Normansrule/arc22-scanner/docs/img/arc22_section_display.png

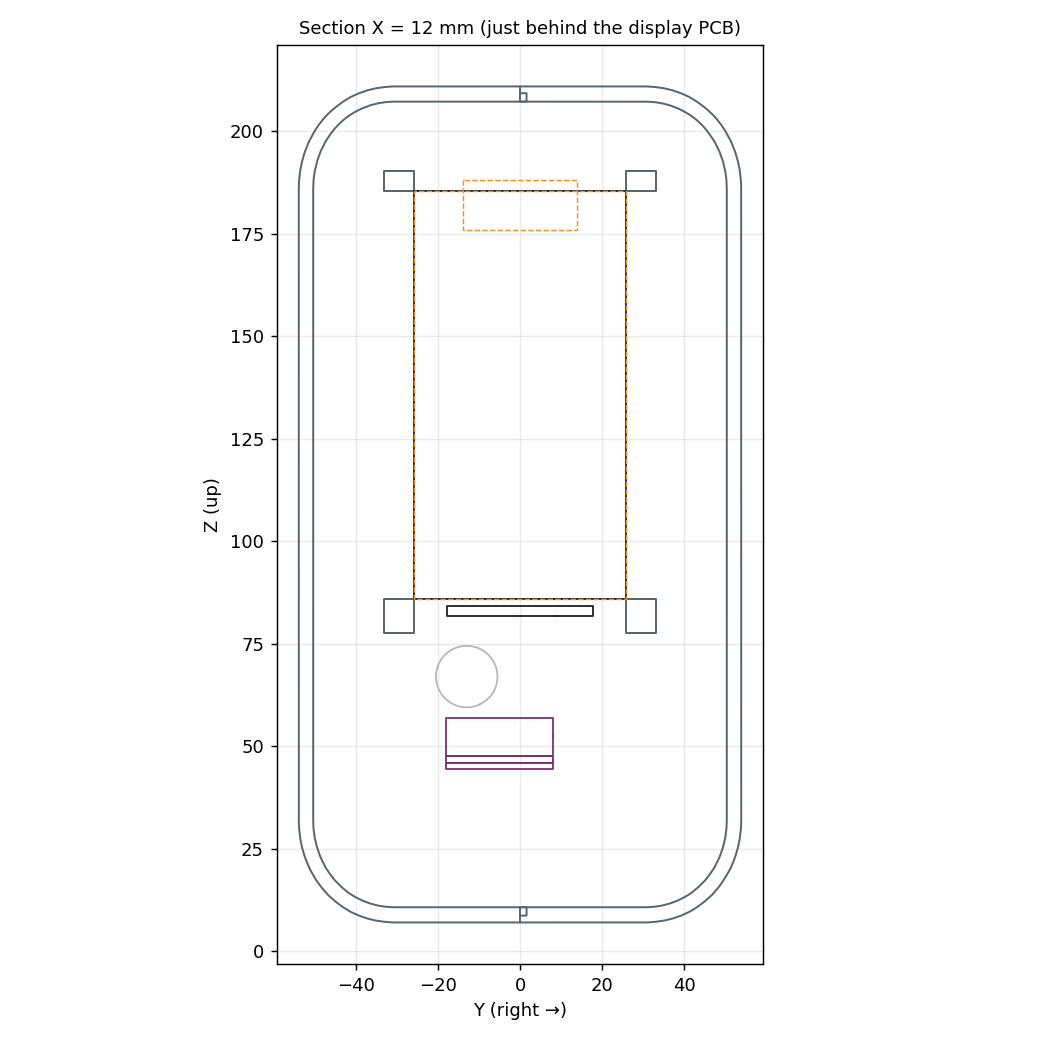
docs/img/arc22_section_display.png
