Normansrule/arc22-scanner/docs/img/arc22_section_esp32.png

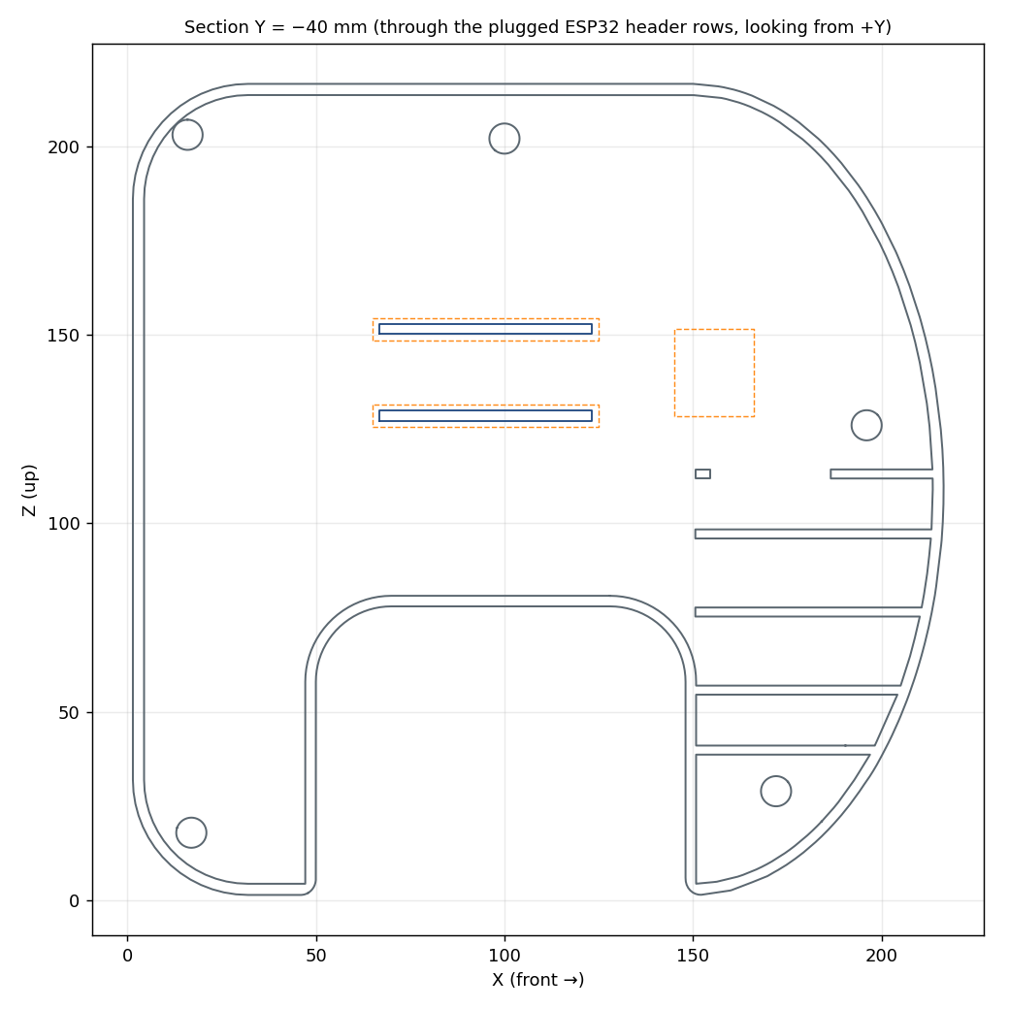
docs/img/arc22_section_esp32.png
