Normansrule/arc22-scanner/docs/img/arc22_section_seam.png

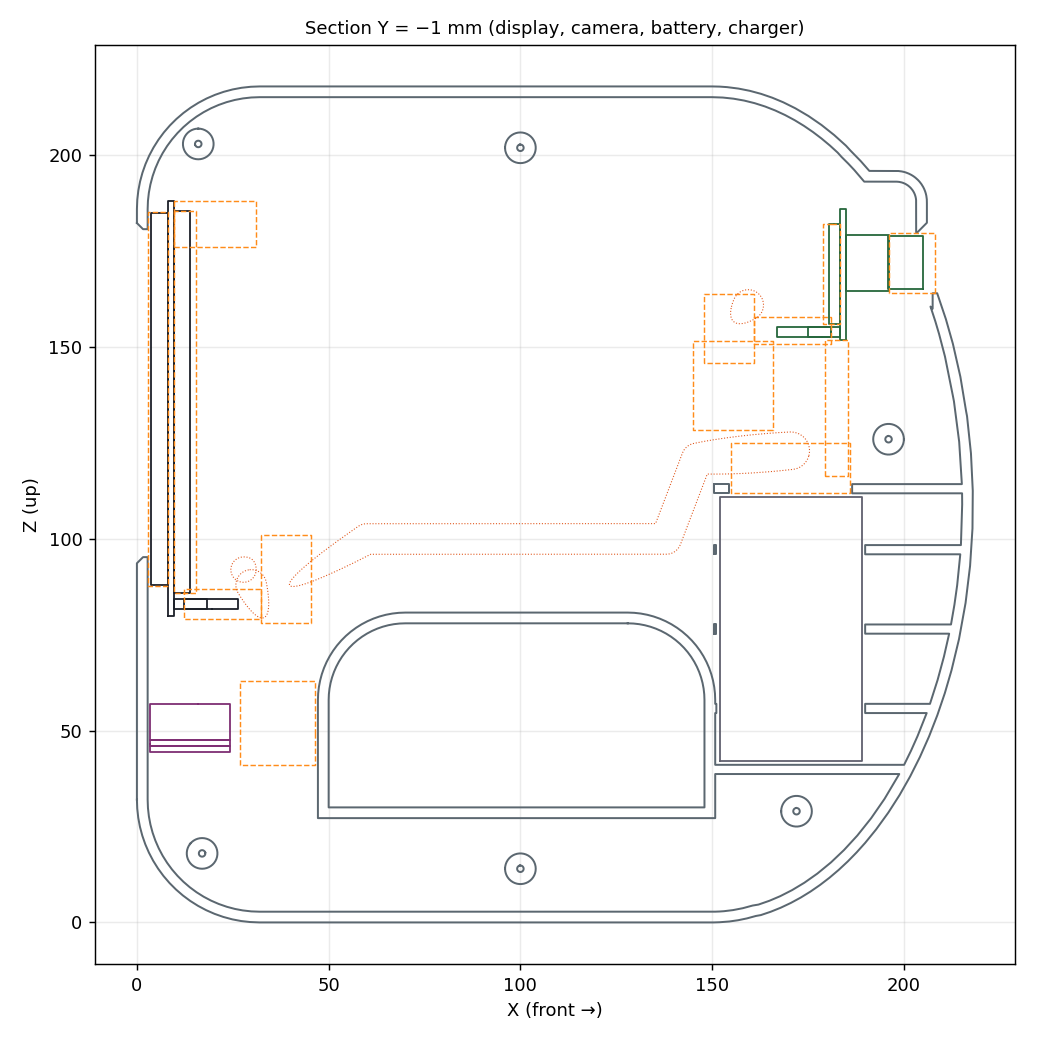
docs/img/arc22_section_seam.png
