Normansrule/arc22-scanner/docs/img/harness.png

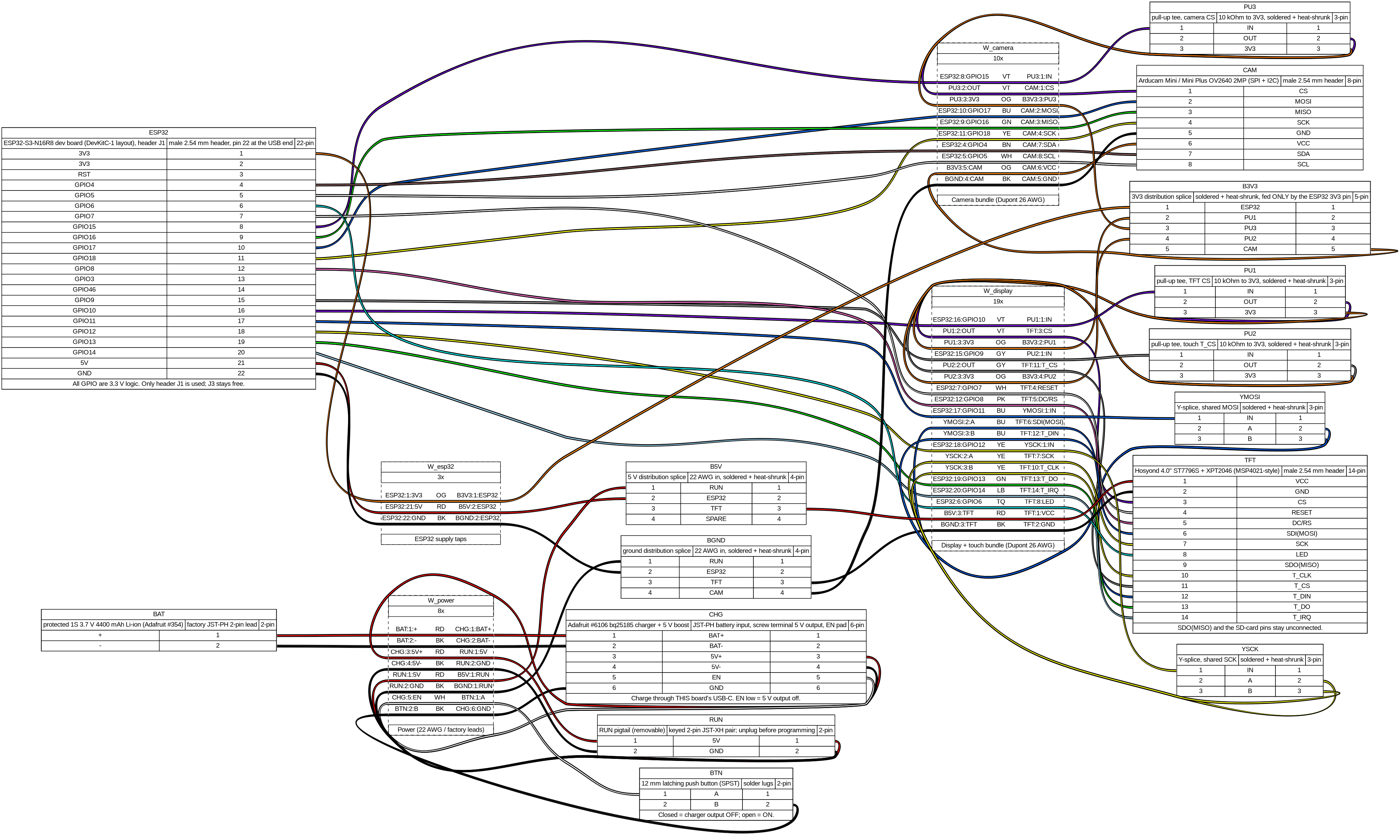
docs/img/harness.png
