Normansrule/arc22-scanner/cad/out/step/ARC22_ASSEMBLY.step

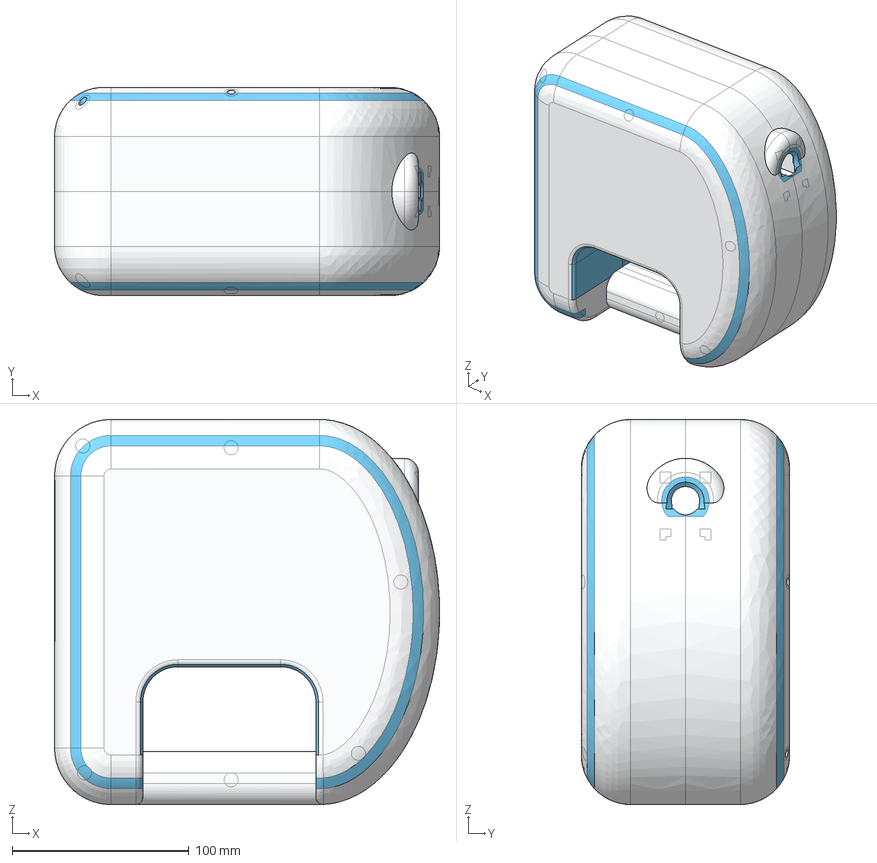
[picture p13: CAD file, 2026-10-02]
cad/out/step/ARC22_ASSEMBLY.step
217.9 x 118.0 x 218.0 mm
LEFT_WHITE
LEFT_BLUE
RIGHT_WHITE
RIGHT_BLUE
