Normansrule/arc22-scanner/cad/out/fit_samples/03_ESP32_WIRED_100x66x44_GAUGE.step

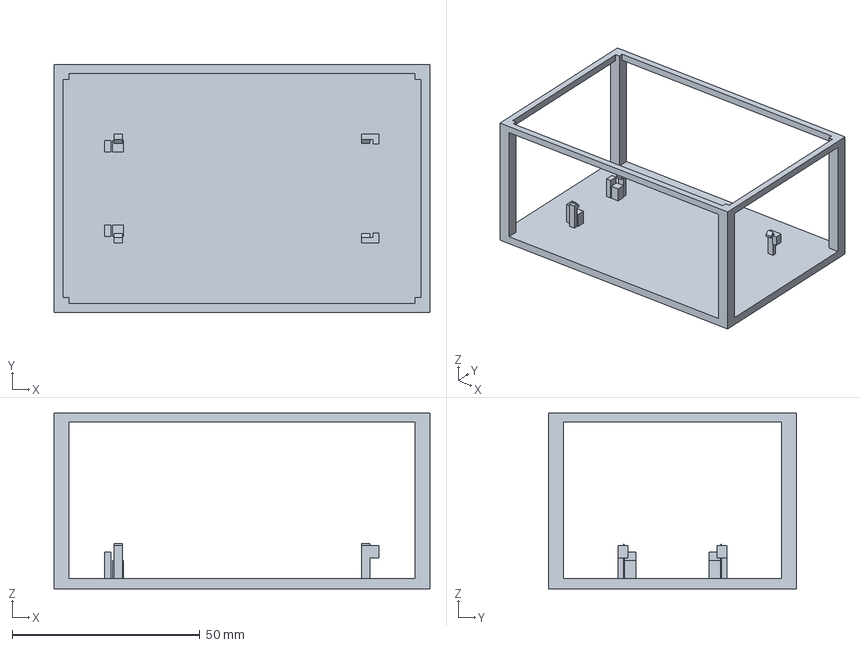
[picture p14: CAD file, 2026-10-02]
cad/out/fit_samples/03_ESP32_WIRED_100x66x44_GAUGE.step
100.0 x 66.0 x 46.8 mm
