Normansrule/arc22-scanner/cad/out/step/ARC22_RIGHT.step

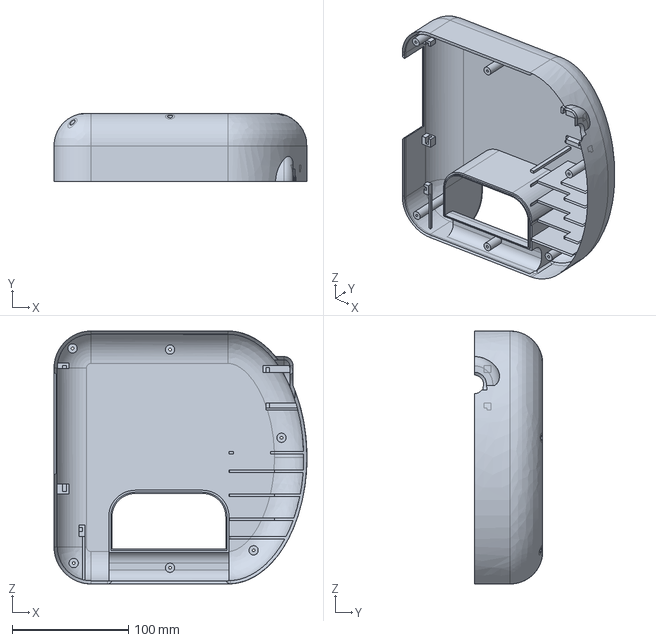
[picture p16: CAD file, 2026-10-02]
cad/out/step/ARC22_RIGHT.step
218.0 x 59.0 x 218.0 mm
