Normansrule/arc22-scanner/cad/reference_cad/ARC22_CLEARANCE_FIELDS.step

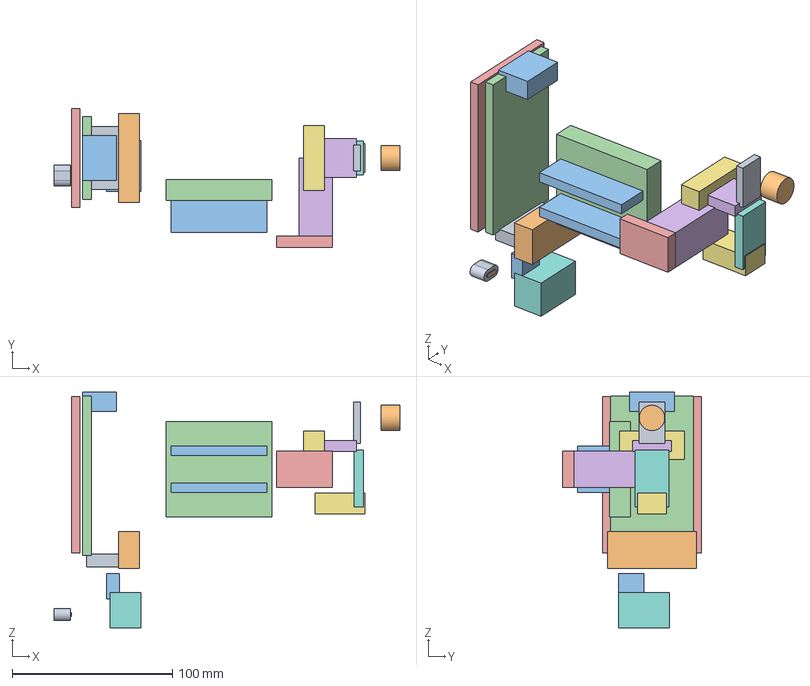
[picture p17: CAD file, 2026-10-02]
cad/reference_cad/ARC22_CLEARANCE_FIELDS.step
216.0 x 86.5 x 147.0 mm
display__hdr_wires_near
display__hdr_wires_bend
display__far_pins
display__open_back
display__glass_air
camera__wires_back_near
camera__wires_back_bend
camera__wires_down
camera__open_back
camera__lens_air
esp32__wires_near_lo
esp32__wires_near_hi
esp32__wires_bend
esp32__prog_usb
esp32__prog_exit
battery__leads
charger__wires
charger__plug_overmold_air
charger__plug_metal_air
button__leads
