Normansrule/arc22-scanner/docs/app/models/mod_display.stl

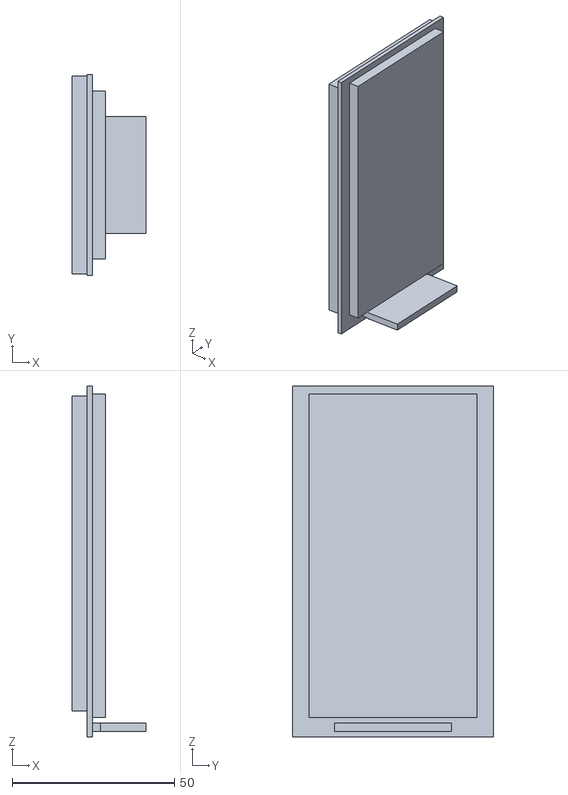
[picture p18: CAD file, 2026-10-02]
docs/app/models/mod_display.stl
22.7 x 61.7 x 108.0
