Normansrule/arc22-scanner/cad/out/fit_samples/01_SCREEN_76x124_BEZEL_AND_PADS.step

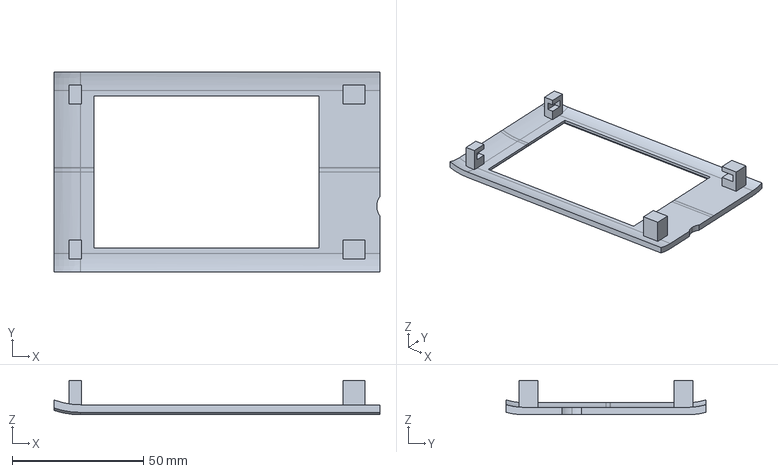
[picture p19: CAD file, 2026-10-02]
cad/out/fit_samples/01_SCREEN_76x124_BEZEL_AND_PADS.step
124.0 x 76.0 x 13.1 mm
