Normansrule/arc22-scanner/cad/out/print/stl/ARC22_LEFT_WHITE.stl

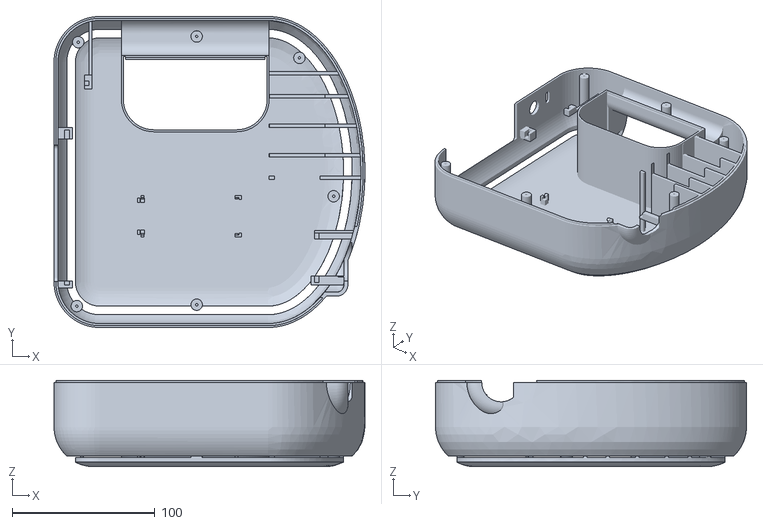
[picture p20: CAD file, 2026-10-02]
cad/out/print/stl/ARC22_LEFT_WHITE.stl
218.0 x 218.0 x 60.6
