Normansrule/arc22-scanner/cad/reference_cad/ARC22_TOPOLOGY.step

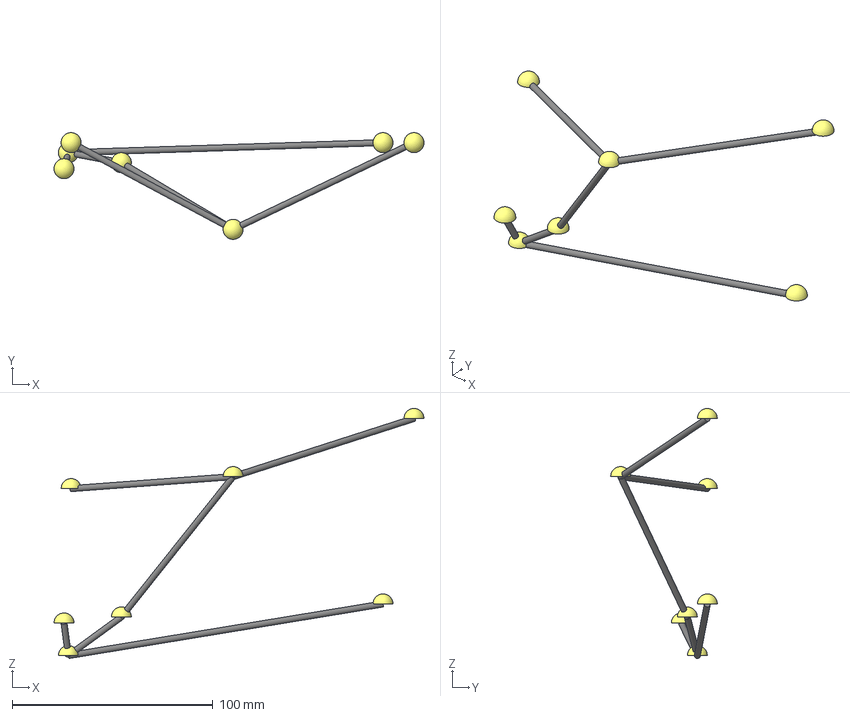
[picture p21: CAD file, 2026-10-02]
cad/reference_cad/ARC22_TOPOLOGY.step
184.5 x 53.2 x 124.7 mm
node_display
node_camera
node_esp32
node_battery
node_charger
node_button
node_run_pigtail
link_camera_esp32
link_esp32_display
link_battery_charger
link_charger_run_pigtail
link_run_pigtail_esp32
link_button_charger
