Normansrule/arc22-scanner/docs/app/models/field_display.stl

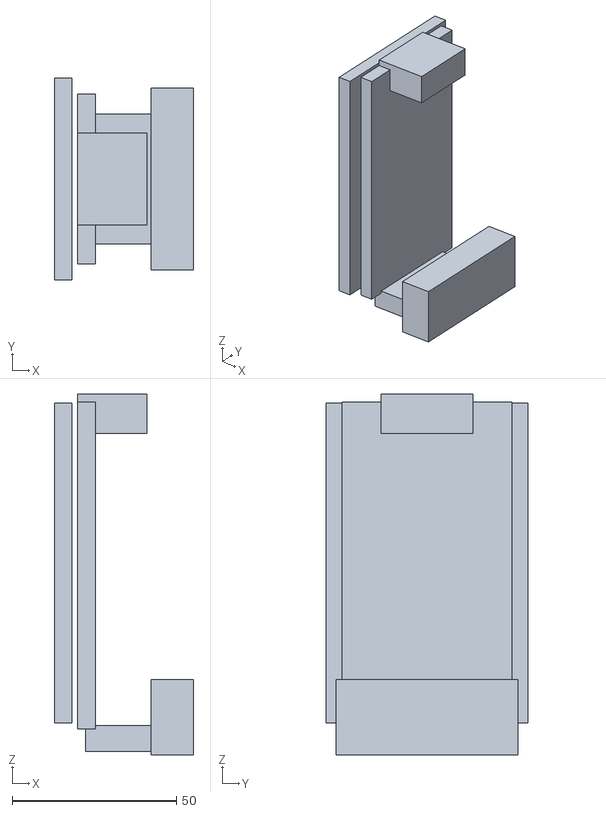
[picture p22: CAD file, 2026-10-02]
docs/app/models/field_display.stl
42.5 x 61.6 x 110.0
