Normansrule/arc22-scanner/cad/out/fit_samples/02_CAMERA_46x50_LENS_AND_PADS.step

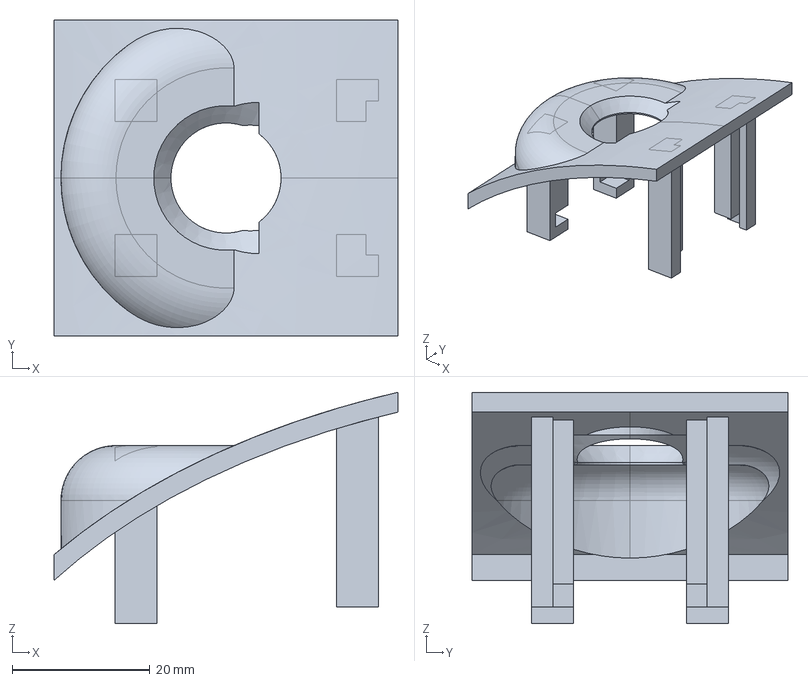
[picture p23: CAD file, 2026-10-02]
cad/out/fit_samples/02_CAMERA_46x50_LENS_AND_PADS.step
50.0 x 46.0 x 33.6 mm
