Normansrule/arc22-scanner/cad/out/print/stl/ARC22_RIGHT_WHITE.stl

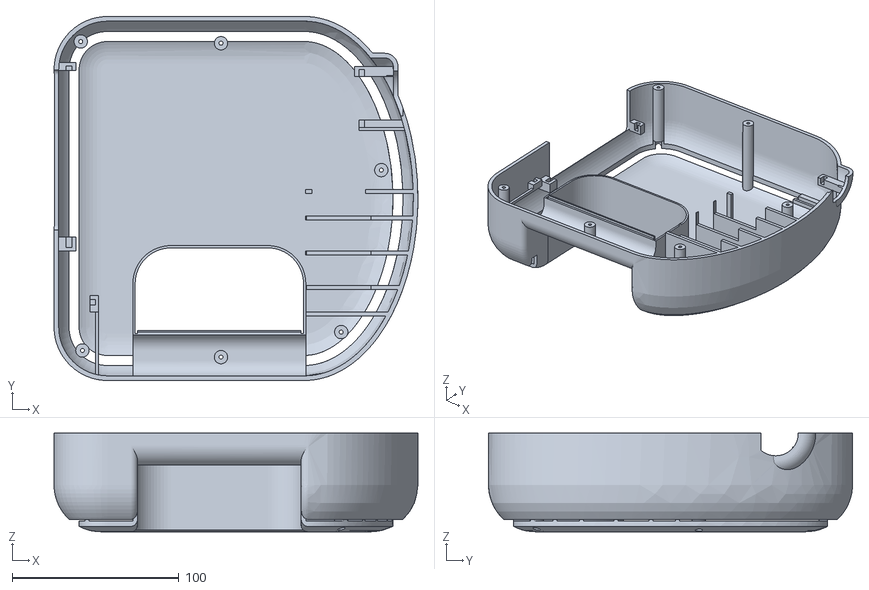
[picture p24: CAD file, 2026-10-02]
cad/out/print/stl/ARC22_RIGHT_WHITE.stl
218.0 x 218.0 x 59.0
