Normansrule/arc22-scanner/cad/out/step/ARC22_RIGHT_2COLOR.step

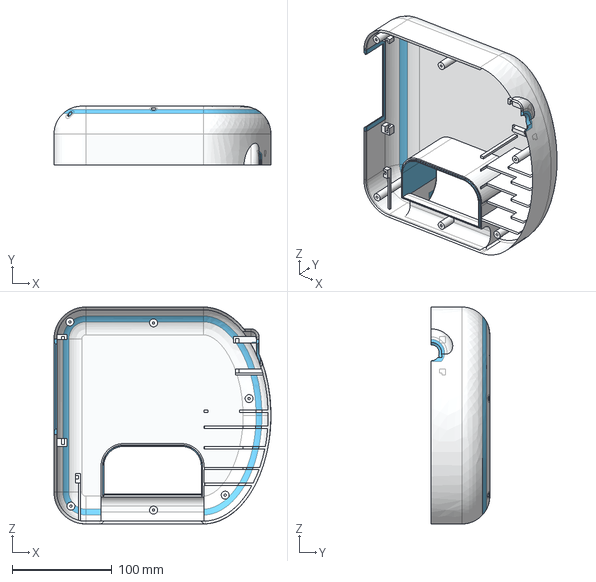
[picture p25: CAD file, 2026-10-02]
cad/out/step/ARC22_RIGHT_2COLOR.step
218.0 x 59.0 x 218.0 mm
RIGHT_WHITE
RIGHT_BLUE
