Normansrule/arc22-scanner/cad/reference_cad/ARC22_REFERENCE_MODULES.step

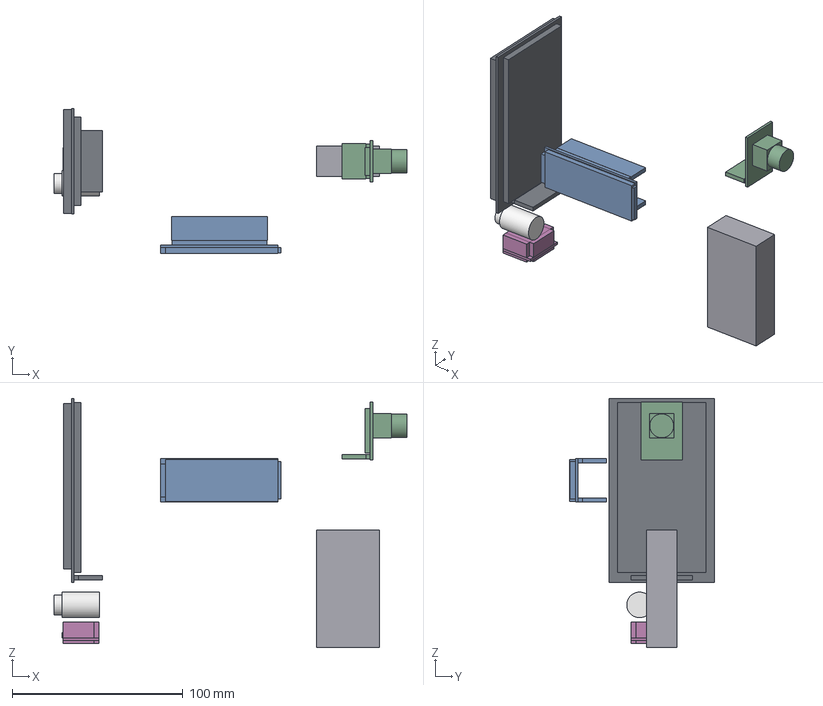
[picture p26: CAD file, 2026-10-02]
cad/reference_cad/ARC22_REFERENCE_MODULES.step
207.0 x 84.9 x 146.0 mm
display__pcb
display__glass
display__back_parts
display__header
display__plugs
camera__pcb
camera__holder
camera__lens
camera__back_parts
camera__header
camera__plugs
esp32__pcb
esp32__top_parts
esp32__top_parts_mid
esp32__usb
esp32__header_lo
esp32__plugs_lo
esp32__header_hi
esp32__plugs_hi
battery__pack
charger__pcb
charger__parts_top
charger__parts_bottom
charger__usb_c
button__body
button__cap
