Normansrule/arc22-scanner/docs/app/models/mod_battery.stl

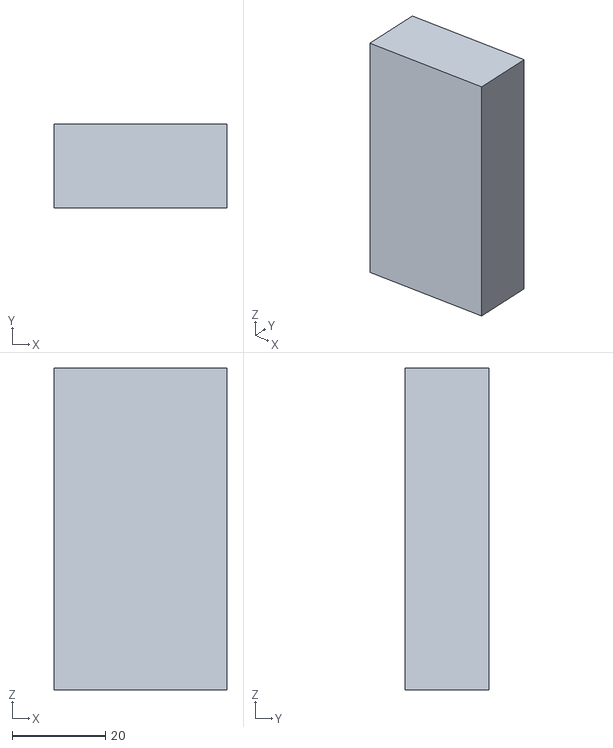
[picture p27: CAD file, 2026-10-02]
docs/app/models/mod_battery.stl
37.0 x 18.0 x 69.0
