Normansrule/arc22-scanner/cad/out/print/stl/ARC22_LEFT_BLUE.stl

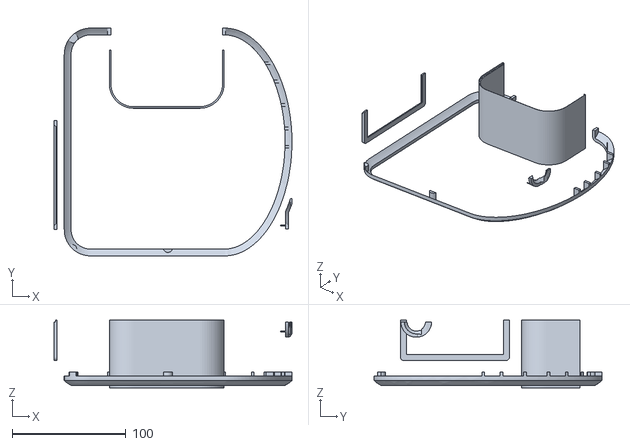
[picture p28: CAD file, 2026-10-02]
cad/out/print/stl/ARC22_LEFT_BLUE.stl
209.0 x 200.0 x 59.6
