Normansrule/arc22-scanner/cad/out/step/ARC22_LEFT.step

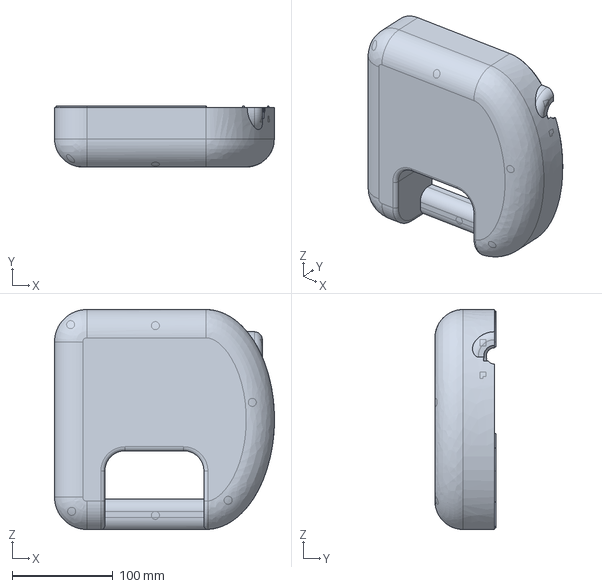
[picture p29: CAD file, 2026-10-02]
cad/out/step/ARC22_LEFT.step
218.0 x 60.6 x 218.0 mm
