Normansrule/arc22-scanner/cad/reference_cad/ARC22_WIRE_ROUTES.step

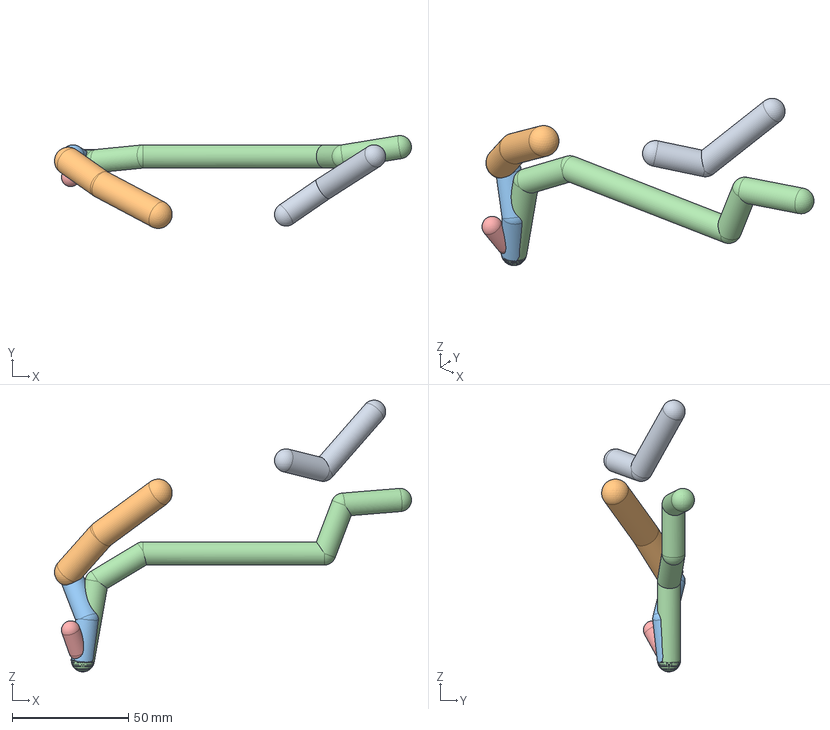
[picture p30: CAD file, 2026-10-02]
cad/reference_cad/ARC22_WIRE_ROUTES.step
153.7 x 40.0 x 117.0 mm
camera_to_esp32
esp32_to_display
power_trunk_to_charger
battery_to_charger
button_to_charger
