Normansrule/arc22-scanner/docs/app/models/mod_button.stl

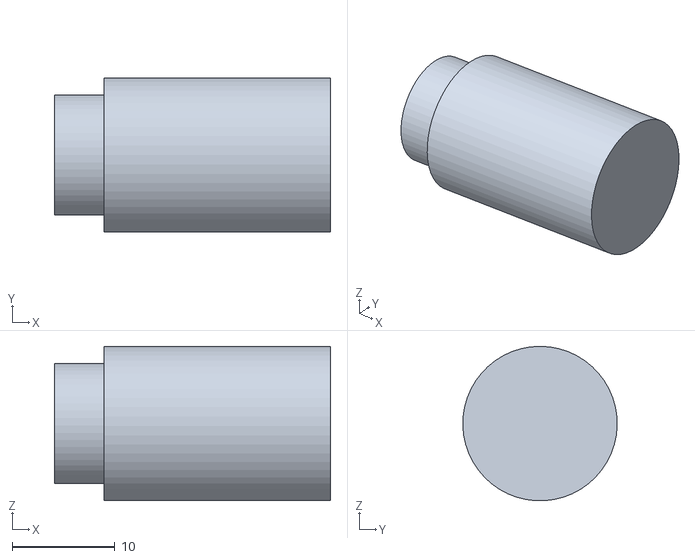
[picture p31: CAD file, 2026-10-02]
docs/app/models/mod_button.stl
26.8 x 15.0 x 15.0
