Normansrule/arc22-scanner/cad/out/step/ARC22_LEFT_2COLOR.step

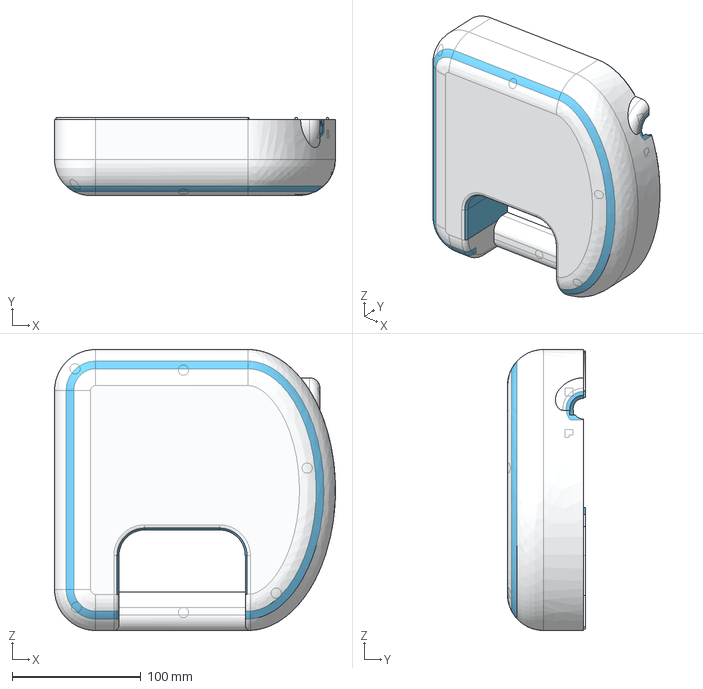
[picture p32: CAD file, 2026-10-02]
cad/out/step/ARC22_LEFT_2COLOR.step
218.0 x 60.6 x 218.0 mm
LEFT_WHITE
LEFT_BLUE
