Normansrule/arc22-scanner/docs/app/models/mod_esp32.stl

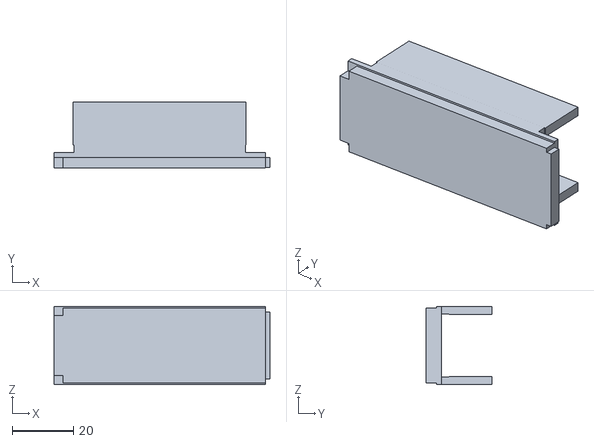
[picture p33: CAD file, 2026-10-02]
docs/app/models/mod_esp32.stl
70.5 x 21.5 x 25.6
