Normansrule/arc22-scanner/docs/app/models/field_button.stl

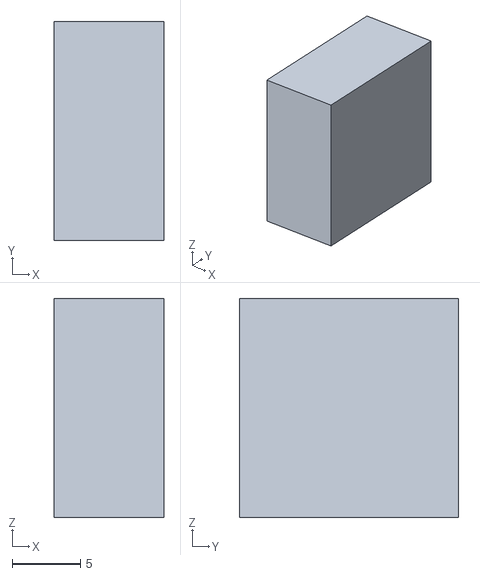
[picture p34: CAD file, 2026-10-02]
docs/app/models/field_button.stl
8.00 x 16.0 x 16.0
