Normansrule/arc22-scanner/docs/app/models/routes.stl

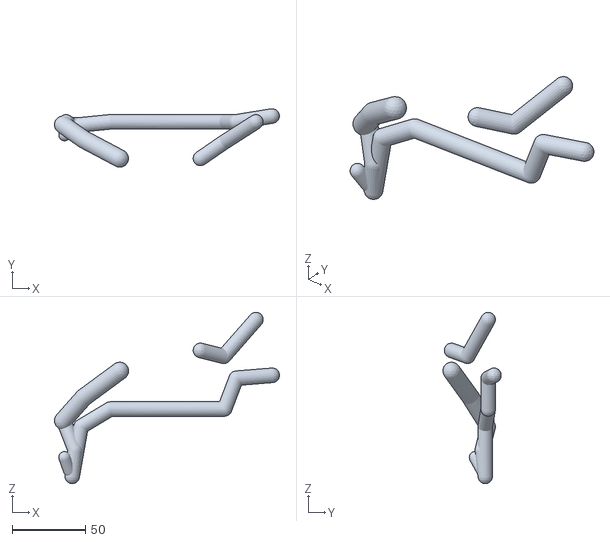
[picture p35: CAD file, 2026-10-02]
docs/app/models/routes.stl
153.6 x 39.9 x 117.0
