Normansrule/arc22-scanner/docs/app/models/mod_charger.stl

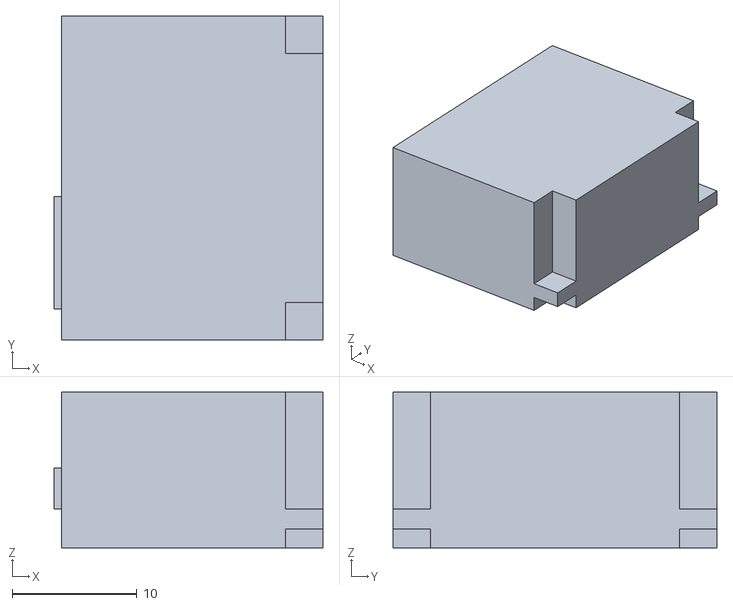
[picture p36: CAD file, 2026-10-02]
docs/app/models/mod_charger.stl
21.6 x 26.0 x 12.5
