Normansrule/arc22-scanner/docs/app/models/field_charger.stl

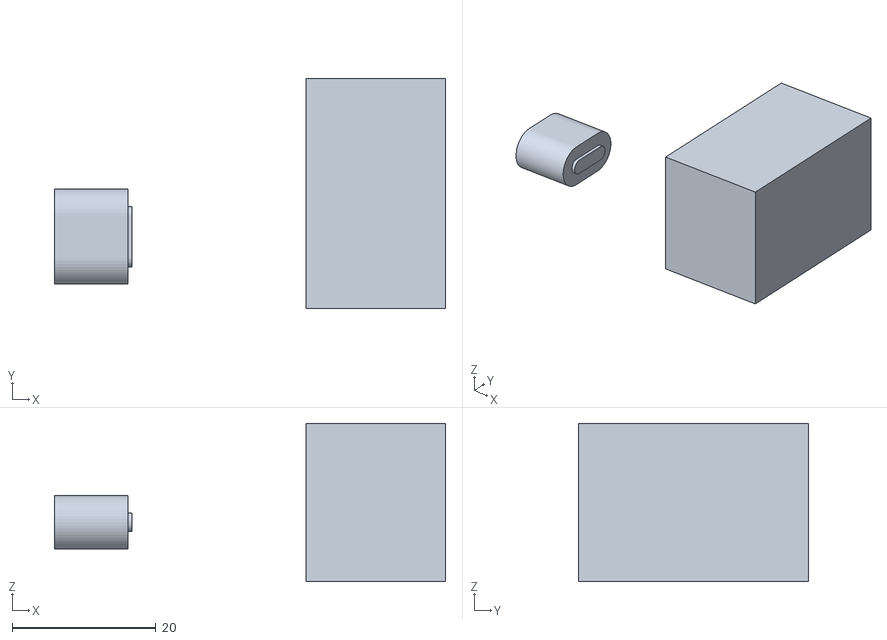
[picture p37: CAD file, 2026-10-02]
docs/app/models/field_charger.stl
54.4 x 32.0 x 22.0
