Normansrule/arc22-scanner/docs/app/models/field_battery.stl

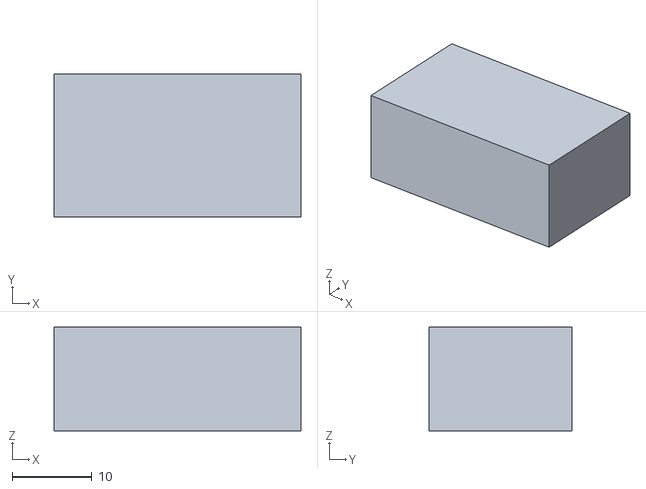
[picture p38: CAD file, 2026-10-02]
docs/app/models/field_battery.stl
31.0 x 18.0 x 13.0
