Normansrule/arc22-scanner/docs/app/models/mod_camera.stl

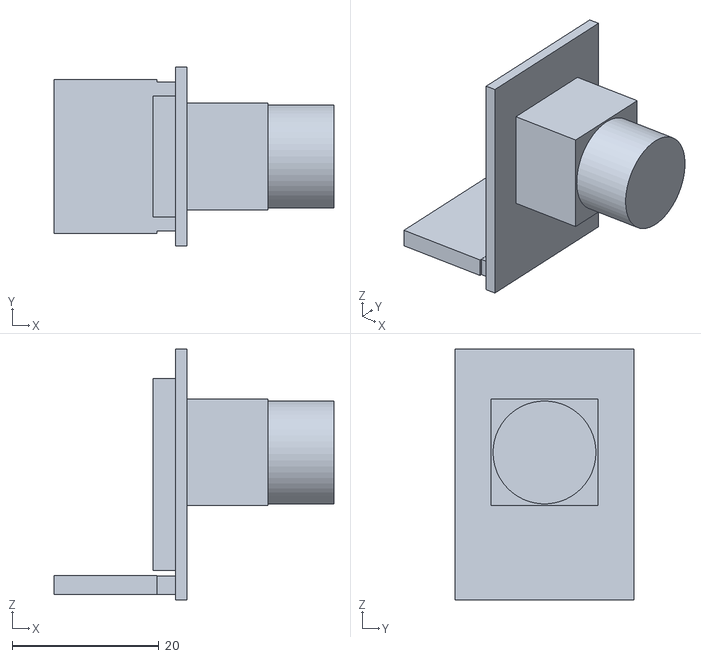
[picture p39: CAD file, 2026-10-02]
docs/app/models/mod_camera.stl
38.1 x 24.4 x 34.1
