Normansrule/arc22-scanner/docs/app/models/field_camera.stl

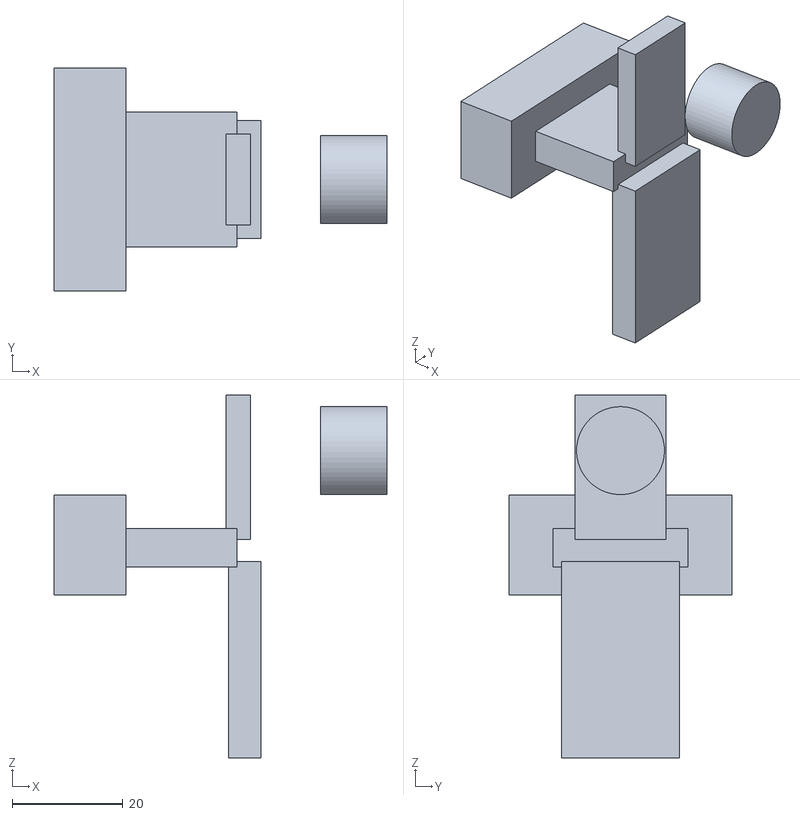
[picture p40: CAD file, 2026-10-02]
docs/app/models/field_camera.stl
60.1 x 40.3 x 65.6
