Normansrule/arc22-scanner/docs/app/models/field_esp32.stl

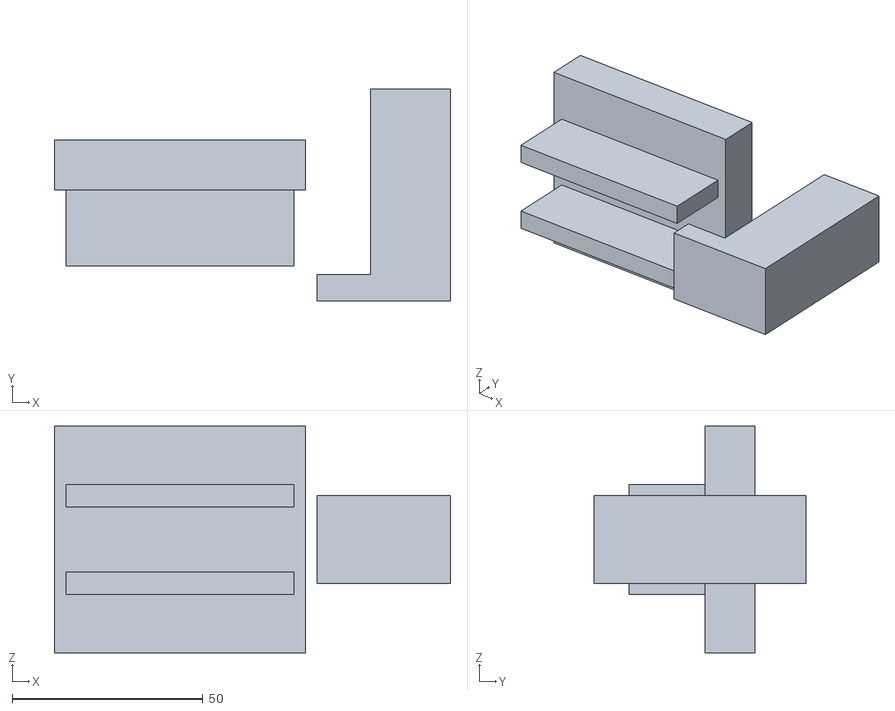
[picture p41: CAD file, 2026-10-02]
docs/app/models/field_esp32.stl
103.9 x 55.8 x 59.5
