Normansrule/arc22-scanner/(list of files, cad)

Other CAD files:
docs/app/models/RIGHT_BLUE.stl
docs/app/models/LEFT_WHITE.stl
docs/app/models/RIGHT_WHITE.stl
docs/app/models/LEFT_BLUE.stl
cad/out/fit_samples/01_SCREEN_76x124_BEZEL_AND_PADS.stl
cad/out/fit_samples/02_CAMERA_46x50_LENS_AND_PADS.stl
cad/out/fit_samples/03_ESP32_WIRED_100x66x44_GAUGE.stl
cad/out/print/3mf/ARC22_LEFT_2COLOR.3mf
cad/out/print/3mf/ARC22_RIGHT_2COLOR.3mf
cad/out/print/ARC22_LEFT.obj
cad/out/print/ARC22_RIGHT.obj
