Normansrule/arc22-scanner/docs/validation/cad_checks.md

# Recorded CAD checks (auto-generated by `cad/validate_arc22.py`)

These are **RECORDED CAD/mesh checks**, not physical tests. 57 measurements are still marked VERIFY, so a PASS means the model is self-consistent with nominal numbers — nothing more.

**99 / 99 passed, 0 failed.**

| Group | Item | Result | Value | Note |
|---|---|---|---|---|
| envelope | bounds X×Y×Z (front-back × width × height) | PASS | 218.0 × 118.0 × 218.0 mm | ARC22 target ~218 × 118 × 218 |
| envelope | LEFT one solid, valid | PASS | 1 solid(s) |  |
| printer | LEFT on P1S bed (exterior down) | PASS | footprint 218.0 × 218.0, height 60.6 mm | bed 256³ minus 10 mm margin for brim/purge/exclusions |
| envelope | RIGHT one solid, valid | PASS | 1 solid(s) |  |
| printer | RIGHT on P1S bed (exterior down) | PASS | footprint 218.0 × 218.0, height 59.0 mm | bed 256³ minus 10 mm margin for brim/purge/exclusions |
| hard parts vs shells | battery.pack | PASS | 0.00 mm³ |  |
| hard parts vs shells | button.body | PASS | 0.00 mm³ |  |
| hard parts vs shells | button.cap | PASS | 0.00 mm³ |  |
| hard parts vs shells | camera.back_parts | PASS | 0.00 mm³ |  |
| hard parts vs shells | camera.header | PASS | 0.00 mm³ |  |
| hard parts vs shells | camera.holder | PASS | 0.00 mm³ |  |
| hard parts vs shells | camera.lens | PASS | 0.00 mm³ |  |
| hard parts vs shells | camera.pcb | PASS | 0.00 mm³ |  |
| hard parts vs shells | camera.plugs | PASS | 0.00 mm³ |  |
| hard parts vs shells | charger.parts_bottom | PASS | 0.00 mm³ |  |
| hard parts vs shells | charger.parts_top | PASS | 0.00 mm³ |  |
| hard parts vs shells | charger.pcb | PASS | 0.00 mm³ |  |
| hard parts vs shells | charger.usb_c | PASS | 0.00 mm³ |  |
| hard parts vs shells | display.back_parts | PASS | 0.00 mm³ |  |
| hard parts vs shells | display.glass | PASS | 0.00 mm³ |  |
| hard parts vs shells | display.header | PASS | 0.00 mm³ |  |
| hard parts vs shells | display.pcb | PASS | 0.00 mm³ |  |
| hard parts vs shells | display.plugs | PASS | 0.00 mm³ |  |
| hard parts vs shells | esp32.header_hi | PASS | 0.00 mm³ |  |
| hard parts vs shells | esp32.header_lo | PASS | 0.00 mm³ |  |
| hard parts vs shells | esp32.pcb | PASS | 0.00 mm³ |  |
| hard parts vs shells | esp32.plugs_hi | PASS | 0.00 mm³ |  |
| hard parts vs shells | esp32.plugs_lo | PASS | 0.00 mm³ |  |
| hard parts vs shells | esp32.top_parts | PASS | 0.00 mm³ |  |
| hard parts vs shells | esp32.top_parts_mid | PASS | 0.00 mm³ |  |
| hard parts vs shells | esp32.usb | PASS | 0.00 mm³ |  |
| reserved fields vs shells | battery.leads | PASS | 0.00 mm³ | wire/air space stays free of plastic |
| reserved fields vs shells | button.leads | PASS | 0.00 mm³ | wire/air space stays free of plastic |
| reserved fields vs shells | camera.lens_air | PASS | 0.00 mm³ | wire/air space stays free of plastic |
| reserved fields vs shells | camera.open_back | PASS | 0.00 mm³ | wire/air space stays free of plastic |
| reserved fields vs shells | camera.wires_back_bend | PASS | 0.00 mm³ | wire/air space stays free of plastic |
| reserved fields vs shells | camera.wires_back_near | PASS | 0.00 mm³ | wire/air space stays free of plastic |
| reserved fields vs shells | camera.wires_down | PASS | 0.00 mm³ | wire/air space stays free of plastic |
| reserved fields vs shells | charger.plug_metal_air | PASS | 0.00 mm³ | wire/air space stays free of plastic |
| reserved fields vs shells | charger.plug_overmold_air | PASS | 0.00 mm³ | wire/air space stays free of plastic |
| reserved fields vs shells | charger.wires | PASS | 0.00 mm³ | wire/air space stays free of plastic |
| reserved fields vs shells | display.far_pins | PASS | 0.00 mm³ | wire/air space stays free of plastic |
| reserved fields vs shells | display.glass_air | PASS | 0.00 mm³ | wire/air space stays free of plastic |
| reserved fields vs shells | display.hdr_wires_bend | PASS | 0.00 mm³ | wire/air space stays free of plastic |
| reserved fields vs shells | display.hdr_wires_near | PASS | 0.00 mm³ | wire/air space stays free of plastic |
| reserved fields vs shells | display.open_back | PASS | 0.00 mm³ | wire/air space stays free of plastic |
| reserved fields vs shells | esp32.prog_exit | PASS | 0.00 mm³ | wire/air space stays free of plastic |
| reserved fields vs shells | esp32.prog_usb | PASS | 0.00 mm³ | wire/air space stays free of plastic |
| reserved fields vs shells | esp32.wires_bend | PASS | 0.00 mm³ | wire/air space stays free of plastic |
| reserved fields vs shells | esp32.wires_near_hi | PASS | 0.00 mm³ | wire/air space stays free of plastic |
| reserved fields vs shells | esp32.wires_near_lo | PASS | 0.00 mm³ | wire/air space stays free of plastic |
| module-to-module room | battery ↔ button | PASS | 0.00 mm³ | hard parts never sit in another module's wire field |
| module-to-module room | battery ↔ camera | PASS | 0.00 mm³ | hard parts never sit in another module's wire field |
| module-to-module room | battery ↔ charger | PASS | 0.00 mm³ | hard parts never sit in another module's wire field |
| module-to-module room | battery ↔ display | PASS | 0.00 mm³ | hard parts never sit in another module's wire field |
| module-to-module room | battery ↔ esp32 | PASS | 0.00 mm³ | hard parts never sit in another module's wire field |
| module-to-module room | button ↔ camera | PASS | 0.00 mm³ | hard parts never sit in another module's wire field |
| module-to-module room | button ↔ charger | PASS | 0.00 mm³ | hard parts never sit in another module's wire field |
| module-to-module room | button ↔ display | PASS | 0.00 mm³ | hard parts never sit in another module's wire field |
| module-to-module room | button ↔ esp32 | PASS | 0.00 mm³ | hard parts never sit in another module's wire field |
| module-to-module room | camera ↔ charger | PASS | 0.00 mm³ | hard parts never sit in another module's wire field |
| module-to-module room | camera ↔ display | PASS | 0.00 mm³ | hard parts never sit in another module's wire field |
| module-to-module room | camera ↔ esp32 | PASS | 0.00 mm³ | hard parts never sit in another module's wire field |
| module-to-module room | charger ↔ display | PASS | 0.00 mm³ | hard parts never sit in another module's wire field |
| module-to-module room | charger ↔ esp32 | PASS | 0.00 mm³ | hard parts never sit in another module's wire field |
| module-to-module room | display ↔ esp32 | PASS | 0.00 mm³ | hard parts never sit in another module's wire field |
| insertion path (swept) | battery | PASS | 0.00 mm³ | path (+0,+80,+0) → (+0,+0,+0) mm into the LEFT shell (plugs fitted), checked every 1 mm |
| insertion path (swept) | button | PASS | 0.00 mm³ | path (+6,+80,+0) → (+6,+0,+0) → (+0,+0,+0) mm into the LEFT shell (plugs fitted), checked every 1 mm |
| insertion path (swept) | camera | PASS | 0.00 mm³ | path (+0,+80,+0) → (+0,+0,+0) mm into the LEFT shell (plugs fitted), checked every 1 mm |
| insertion path (swept) | charger | PASS | 0.00 mm³ | path (+0,+80,+0) → (+0,+0,+0) mm into the LEFT shell (plugs fitted), checked every 1 mm |
| insertion path (swept) | display | PASS | 0.00 mm³ | path (+0,+80,+0) → (+0,+0,+0) mm into the LEFT shell (plugs fitted), checked every 1 mm |
| insertion path (swept) | esp32 | PASS | 0.00 mm³ | path (+0,+80,+0) → (+0,+0,+0) mm into the LEFT shell (plugs fitted), checked every 1 mm; snap clips engage up to 6.9 mm³ (intended, hook 0.8 mm) |
| closing swept volume | RIGHT shell descending onto fully wired LEFT half | PASS | 0.00 mm³ | includes plugged housings, wire fields and cable routes; checked every 1 mm |
| closing swept volume | RIGHT shell at final position vs installed stack | PASS | 0.00 mm³ | halves meet with no module pressure → close by hand before screws |
| cable routes | camera_to_esp32 inside cavity | PASS | 0.00 mm³ plastic |  |
| cable routes | camera_to_esp32 clear of hard parts | PASS | 0.0 mm³ | ends touch the header/plug zone by design (≤ 50 mm³ allowed) |
| cable routes | esp32_to_display inside cavity | PASS | 0.00 mm³ plastic |  |
| cable routes | esp32_to_display clear of hard parts | PASS | 12.9 mm³ | ends touch the header/plug zone by design (≤ 50 mm³ allowed) |
| cable routes | power_trunk_to_charger inside cavity | PASS | 0.00 mm³ plastic |  |
| cable routes | power_trunk_to_charger clear of hard parts | PASS | 0.5 mm³ | ends touch the header/plug zone by design (≤ 50 mm³ allowed) |
| cable routes | battery_to_charger inside cavity | PASS | 0.00 mm³ plastic |  |
| cable routes | battery_to_charger clear of hard parts | PASS | 0.0 mm³ | ends touch the header/plug zone by design (≤ 50 mm³ allowed) |
| cable routes | button_to_charger inside cavity | PASS | 0.00 mm³ plastic |  |
| cable routes | button_to_charger clear of hard parts | PASS | 0.0 mm³ | ends touch the header/plug zone by design (≤ 50 mm³ allowed) |
| hand loop | loop opening never reaches the electronics cavity | PASS | 0.00 mm³ | loop wall 2.8 mm all round |
| screws | S1_rear_top boss clear of every module | PASS | 12.2 mm gap | screws clamp shell to shell only — never a module |
| screws | S1_rear_top pilot stays blind (left skin ≥ 1.0 mm) | PASS | skin 45.42 mm, M2×12, engagement 7 mm, well 49.42 mm deep |  |
| screws | S2_top_mid boss clear of every module | PASS | 45.2 mm gap | screws clamp shell to shell only — never a module |
| screws | S2_top_mid pilot stays blind (left skin ≥ 1.0 mm) | PASS | skin 48.83 mm, M2×12, engagement 7 mm, well 52.83 mm deep |  |
| screws | S3_bow boss clear of every module | PASS | 12.6 mm gap | screws clamp shell to shell only — never a module |
| screws | S3_bow pilot stays blind (left skin ≥ 1.0 mm) | PASS | skin 49.84 mm, M2×12, engagement 7 mm, well 53.84 mm deep |  |
| screws | S4_front_low boss clear of every module | PASS | 9.0 mm gap | screws clamp shell to shell only — never a module |
| screws | S4_front_low pilot stays blind (left skin ≥ 1.0 mm) | PASS | skin 49.5 mm, M2×12, engagement 7 mm, well 53.5 mm deep |  |
| screws | S5_rear_low boss clear of every module | PASS | 22.5 mm gap | screws clamp shell to shell only — never a module |
| screws | S5_rear_low pilot stays blind (left skin ≥ 1.0 mm) | PASS | skin 47.05 mm, M2×12, engagement 7 mm, well 51.05 mm deep |  |
| screws | S6_grip boss clear of every module | PASS | 55.1 mm gap | screws clamp shell to shell only — never a module |
| screws | S6_grip pilot stays blind (left skin ≥ 1.0 mm) | PASS | skin 10.0 mm, M2×12, engagement 7 mm, well 14.0 mm deep |  |
| two-colour regions | LEFT: WHITE + BLUE = shell, no overlap | PASS | white 243.8 cm³, blue 31.0 cm³, Δ 0.082 %, overlap 0.00 mm³ | same assembly coordinates → identical per-shell print transform |
| two-colour regions | RIGHT: WHITE + BLUE = shell, no overlap | PASS | white 236.9 cm³, blue 30.5 cm³, Δ 0.002 %, overlap 0.00 mm³ | same assembly coordinates → identical per-shell print transform |
