Normansrule/arc22-scanner/docs/validation/mesh_checks.md

# Recorded mesh checks (auto-generated by `cad/export_arc22.py`)

Checks on the exported STL regions. Watertight + consistent winding + volume matching the B-rep means the slicer receives closed solids. It says nothing about how Bambu Studio assigns filaments — that is a PHYSICAL/slicer check (docs/PRINTING.md).

| File | Triangles | Watertight | Winding | Bodies | Mesh cm³ | B-rep cm³ | Δ % |
|---|---|---|---|---|---|---|---|
| ARC22_LEFT_WHITE.stl | 15948 | True | True | 1 | 243.55 | 243.77 | 0.09 |
| ARC22_LEFT_BLUE.stl | 4204 | True | True | 4 | 30.84 | 30.97 | 0.417 |
| ARC22_RIGHT_WHITE.stl | 14704 | True | True | 1 | 236.58 | 236.89 | 0.129 |
| ARC22_RIGHT_BLUE.stl | 4680 | True | True | 4 | 30.4 | 30.53 | 0.413 |
