Normansrule/arc22-scanner/measurements/README.md

# measurements/

Copy `my_units.toml.example` to `my_units.toml` and type in what YOUR calipers say. `my_units.toml` is git-ignored by default (remove that line from `.gitignore` if you want to share your numbers). Guide: [../docs/MEASUREMENTS.md](../docs/MEASUREMENTS.md).
