Normansrule/arc22-scanner/(commit log)

2026-10-02 ARC-22: import 2026-10-02 from arc22-scanner.zip
    [01_SCREEN_76x124_BEZEL_AND_PADS.step, 01_SCREEN_76x124_BEZEL_AND_PADS.stl, 02_CAMERA_46x50_LENS_AND_PADS.step, 02_CAMERA_46x50_LENS_AND_PADS.stl, 03_ESP32_WIRED_100x66x44_GAUGE.step, 03_ESP32_WIRED_100x66x44_GAUGE.stl, ARC22_ASSEMBLY.step, ARC22_CLEARANCE_FIELDS.step]
2026-10-02 Bump scipy from 1.17.1 to 1.18.1 in /cad
    Bumps [scipy](https://github.com/scipy/scipy) from 1.17.1 to 1.18.1.
    - [Release notes](https://github.com/scipy/scipy/releases)
    - [Commits](https://github.com/scipy/scipy/compare/v1.17.1...v1.18.1)
    ---
    updated-dependencies:
    - dependency-name: scipy
    dependency-version: 1.18.1
    dependency-type: direct:production
    update-type: version-update:semver-minor
    ...
