Normansrule/arc22-scanner/(notices)

Notices in the files:
README.md:
Docs: CC BY 4.0
